jdoscher/Meshtastic-Enclosure/Meshtastic Radio - Parts List.rtf

• Makerfocus Heltec v3 915mhz (USA) board with SMA antenna adapter - Amazon (https://amzn.to/46kCa93?ref=doscher.com)
• Makerfocus 3000mAh battery - Amazon (https://amzn.to/3LHDcCo?ref=doscher.com)
• M2.5x20mm Philips head screws - McMaster Carr (https://www.mcmaster.com/91698A722/?ref=doscher.com)
• ZBM2 Industries whip mesh antenna - ZBM2 Industries (https://zbm2industries.com/products/mesh-ant?ref=doscher.com)
• SMA to BNC Adapter - ZBM2 for the cool black one (https://zbm2industries.com/products/sma-f-to-bnc-m?ref=doscher.com)
