jdoscher/Meshtastic-Enclosure/doscher.com heltec suction main body.stl

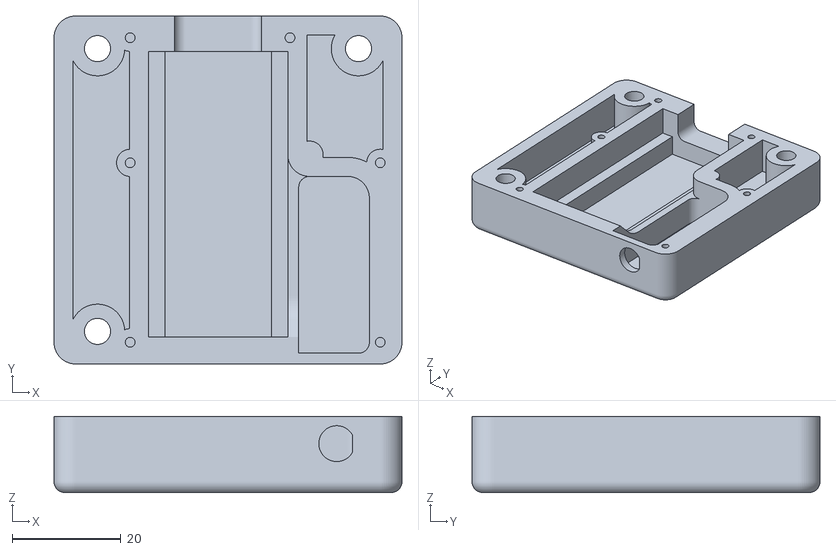
[picture p1: CAD file, 2025-01-02]
doscher.com heltec suction main body.stl
64.0 x 64.0 x 14.0
