jdoscher/Meshtastic-Enclosure/doscher.com heltec mini lid v3.stl

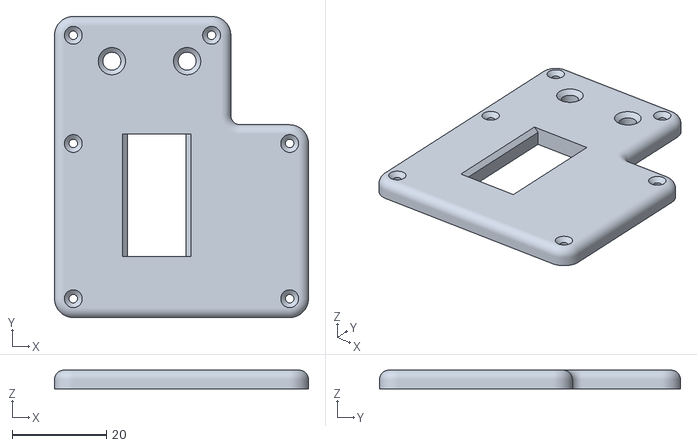
[picture p2: CAD file, 2025-01-02]
doscher.com heltec mini lid v3.stl
54.0 x 64.0 x 4.00
