jdoscher/Meshtastic-Enclosure/doscher.com heltec battery 3000 radio tray.stl

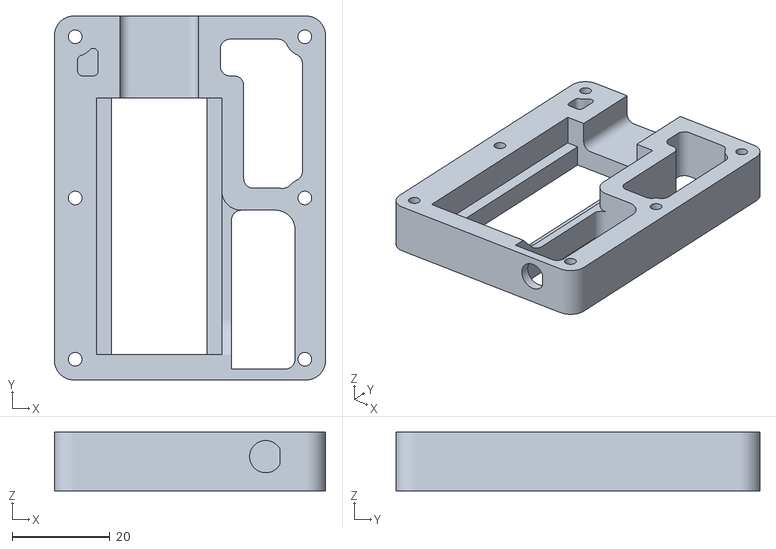
[picture p3: CAD file, 2025-01-02]
doscher.com heltec battery 3000 radio tray.stl
55.5 x 74.5 x 12.0
