jdoscher/Meshtastic-Enclosure/doscher.com heltec tall button v3.stl

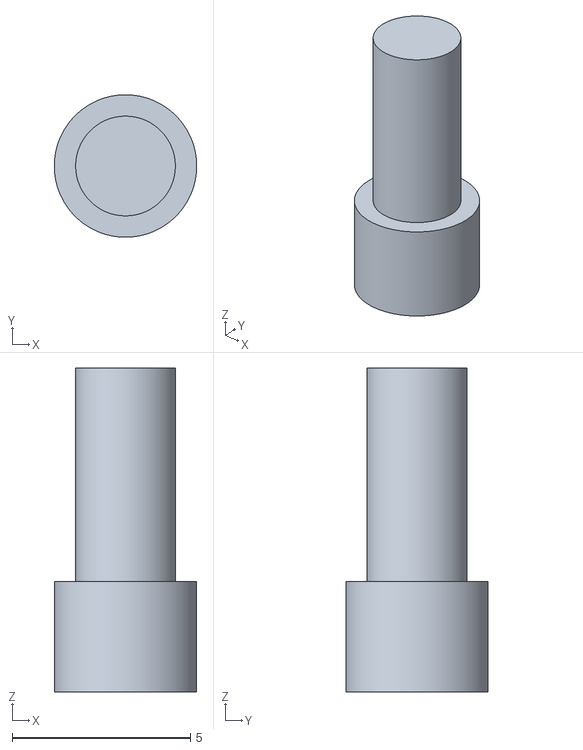
[picture p4: CAD file, 2025-01-02]
doscher.com heltec tall button v3.stl
4.00 x 4.00 x 9.10
