jdoscher/Meshtastic-Enclosure/doscher.com heltec battery 3000m battery tray.stl

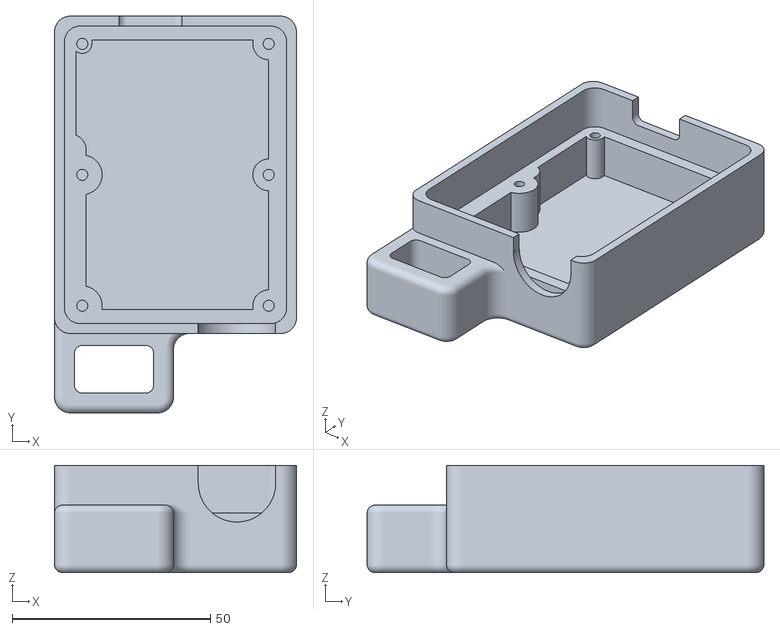
[picture p5: CAD file, 2025-01-02]
doscher.com heltec battery 3000m battery tray.stl
61.0 x 100.0 x 27.0
