jdoscher/Meshtastic-Enclosure/doscher.com heltec mini v1.stl

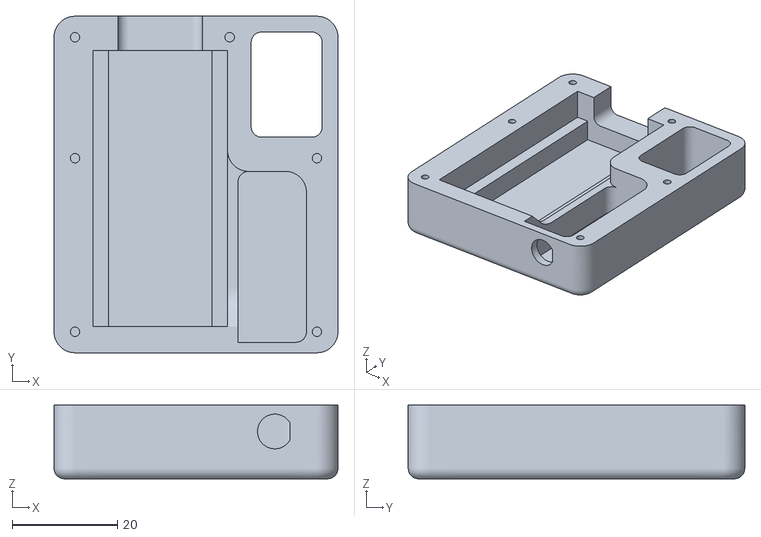
[picture p6: CAD file, 2025-01-02]
doscher.com heltec mini v1.stl
54.0 x 64.0 x 14.0
