jdoscher/Meshtastic-Enclosure/doscher.com heltec suction mini lid v1.stl

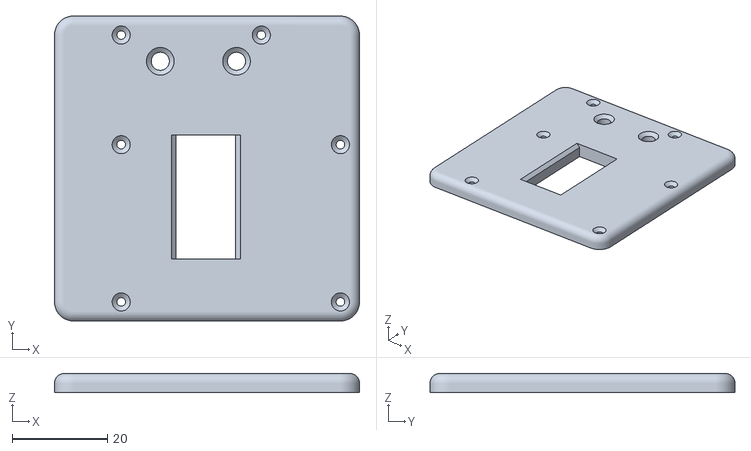
[picture p7: CAD file, 2025-01-02]
doscher.com heltec suction mini lid v1.stl
64.0 x 64.0 x 4.00
