jdoscher/Meshtastic-Enclosure/doscher.com heltec button short button.stl

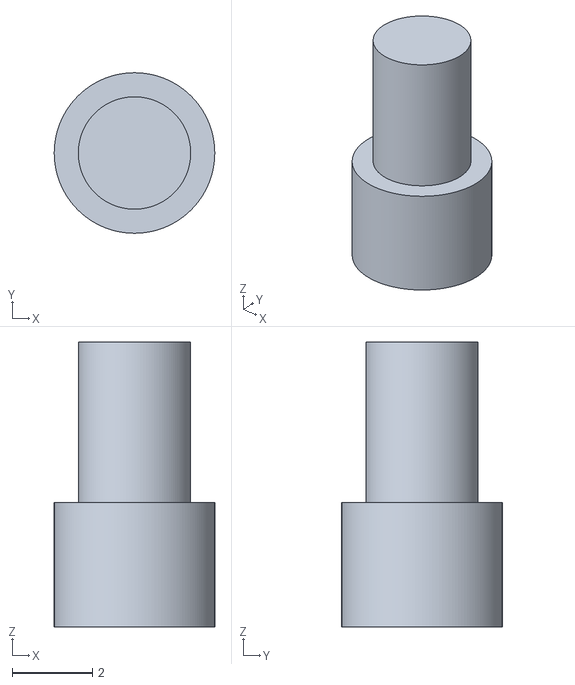
[picture p8: CAD file, 2025-01-02]
doscher.com heltec button short button.stl
4.00 x 4.00 x 7.10
