jdoscher/Meshtastic-Enclosure/doscher.com heltec battery 3000 lid.stl

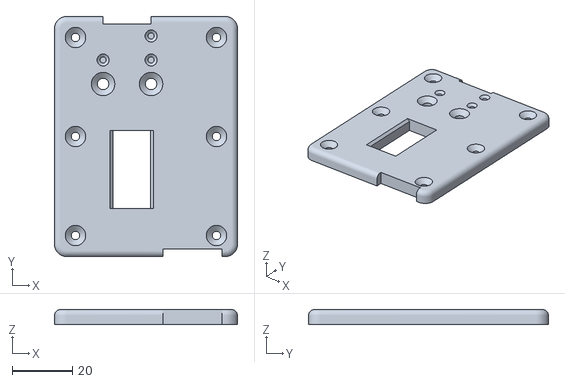
[picture p9: CAD file, 2025-01-02]
doscher.com heltec battery 3000 lid.stl
61.0 x 80.0 x 5.00
