jdoscher/Meshtastic-Enclosure/(list of files, cad)

Other CAD files:
doscher.com Meshtastic Radios v3.f3d
